unlim-int-soumya/ESE-519-FINAL-PROJECT-Penn-Dinosaurs/code/README.md

# Customer-experience enhancement system!
### By - Team Penn Dinosaurs ☘️

## University of Pennsylvania, ESE 5190: Intro to Embedded Systems - Final Project
    SATYAJEET DAS
        LinkedIn: https://www.linkedin.com/in/satyajeet-das/
    Soumya Dash
        LinkedIn: https://www.linkedin.com/in/srd00/
    Qiao Xu
        LinkedIn: https://www.linkedin.com/in/qiao-xu-b520a3249/

    Tested on:DELL Inspiron 16 Plus (16-inch, 2022), Windows 11 Home 21H2

# Code Overview:<br />

### Detailed Explaination of each line of the code is provided in the "comments" of each code. This section explains the code's overall use and logistics.<br />
## 1. Dino_Game_Code_RP2040:<br />
1. dino.c - main dino game code, where all the helper programs combine to produce the overall game.<br />
2. pwmsnd.c  - driver code for running PWM sound during the game.<br />
3. pwmsnd.h - header file for PWM Sound.<br />
3. vga_graphics.c - driver code for running VGA display.<br />
4. vga_graphics.h -  header file for "vga_graphics".<br />
5. rgb.pio, vsync.pio, hsync.pio - PIO code for VGA Display.<br />
6. Bitmaps.h - Bitmap file for generating the DINO and Cactus.<br />
7. jump.h - Jump Sound<br />
8. gameover.h - Gameover Sound<br />
9. CMakeLists.txt - Cmake File <br />
## 2. Face_Tracking_Pan_Tilt:<br />
1. face_new_main.py - main Face Traking Pan-tilt Code.<br />
2. haarcascade_frontalface_default.xml - Machine Learning Model to detect faces<br />
## 3. Human Interaction Interface:<br />
1. code.py - Main Human Interaction Interface Code.<br />
2. blinding_night.mp3, shape.mp3, song_chris.mp3 - Songs to Play<br />
# Thank You !!!
