unlim-int-soumya/ESE-519-FINAL-PROJECT-Penn-Dinosaurs/diagram/Dino Game.png

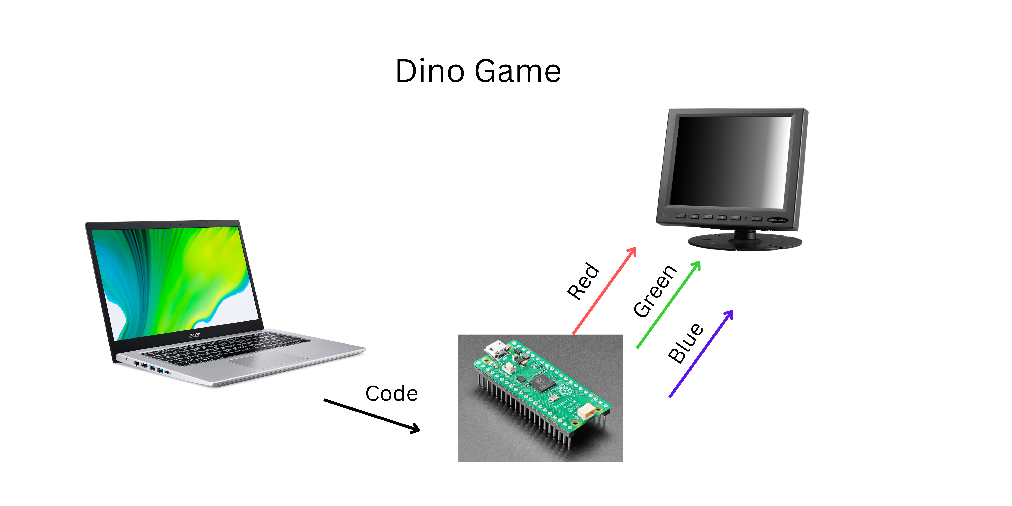
diagram/Dino Game.png
