unlim-int-soumya/ESE-519-FINAL-PROJECT-Penn-Dinosaurs/diagram/ST7735 related pin.jpg

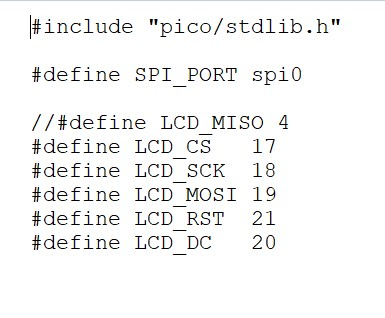
diagram/ST7735 related pin.jpg
