unlim-int-soumya/ESE-519-FINAL-PROJECT-Penn-Dinosaurs/diagram/ST7735 schematic.jpg

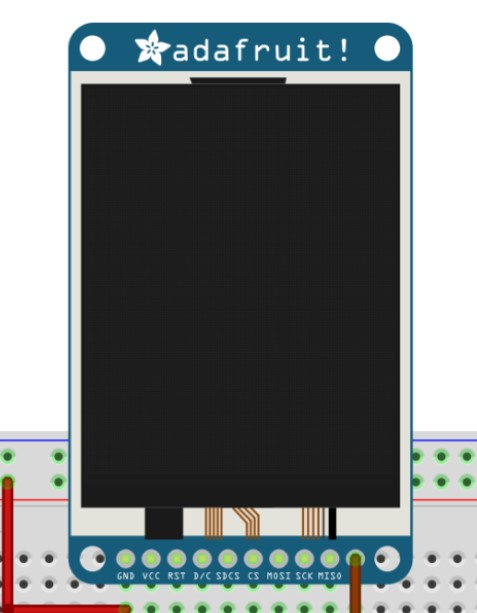
diagram/ST7735 schematic.jpg
