unlim-int-soumya/ESE-519-FINAL-PROJECT-Penn-Dinosaurs/media/Summary of Project.png

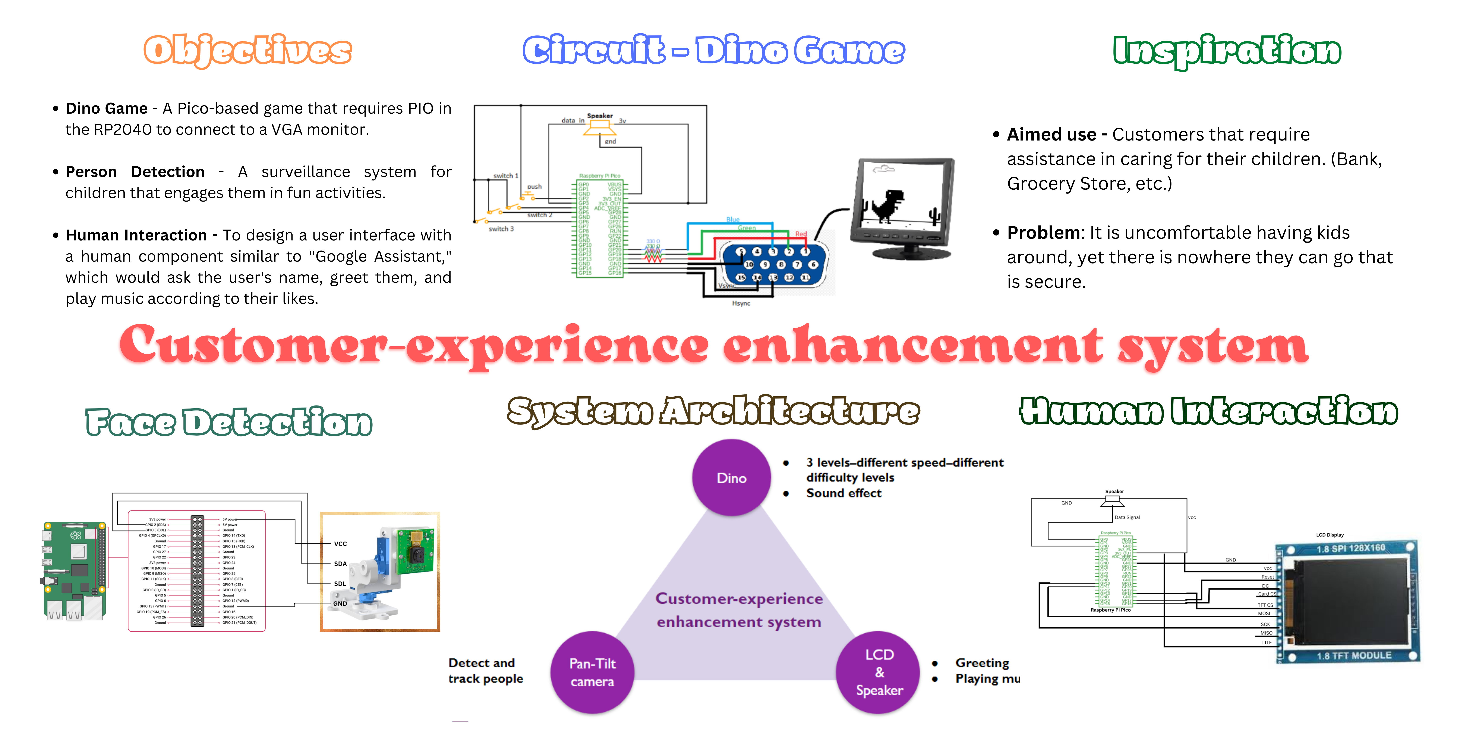
media/Summary of Project.png
