unlim-int-soumya/ESE-519-FINAL-PROJECT-Penn-Dinosaurs/media/materials/1920px-VGA_Port.svg.png

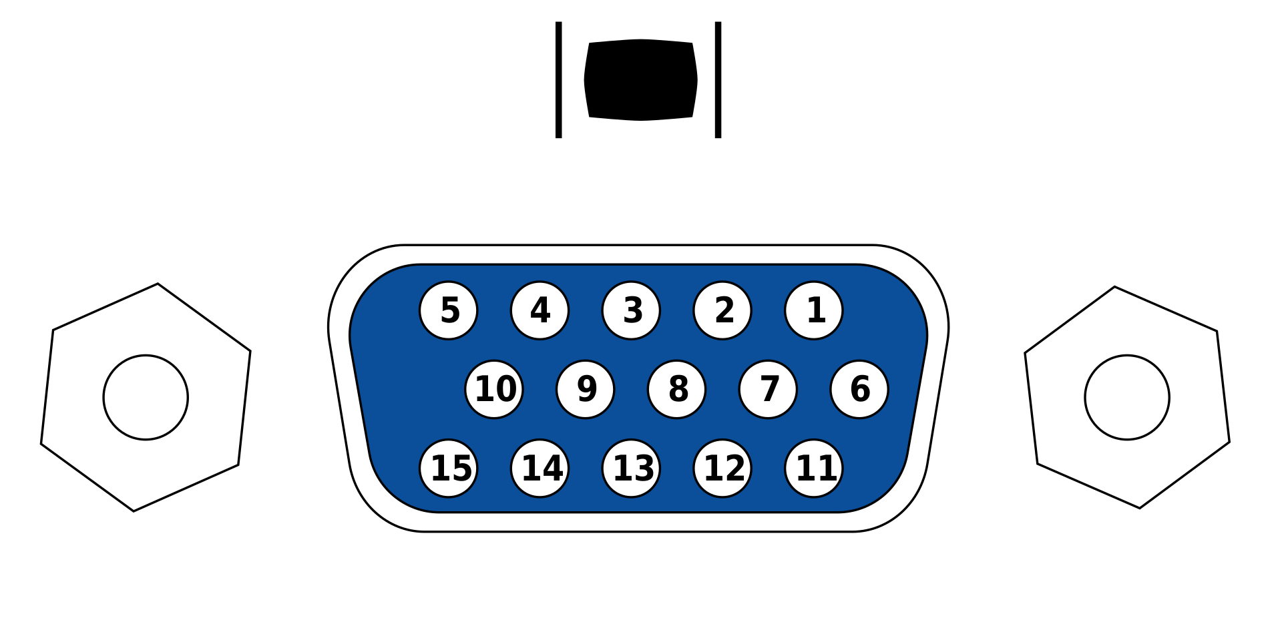
media/materials/1920px-VGA_Port.svg.png
