unlim-int-soumya/ESE-519-FINAL-PROJECT-Penn-Dinosaurs/media/materials/photos of components/pan-tilt.jpg

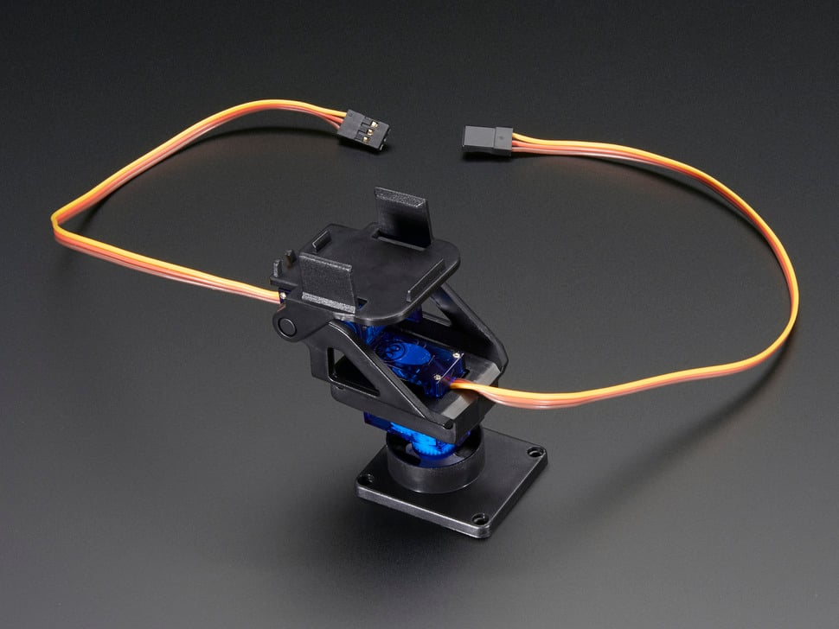
media/materials/photos of components/pan-tilt.jpg
