unlim-int-soumya/ESE-519-FINAL-PROJECT-Penn-Dinosaurs/media/materials/photos of components/Raspberry pi 4 & arducam camera.jpg

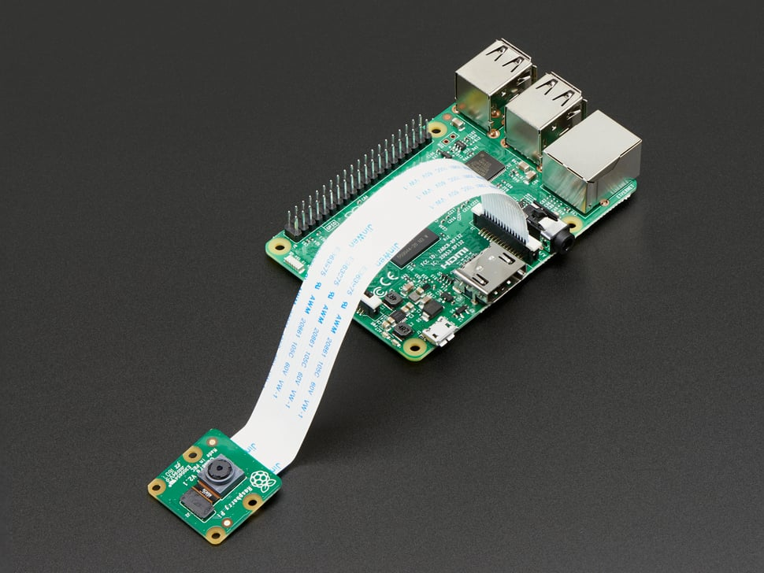
media/materials/photos of components/Raspberry pi 4 & arducam camera.jpg
