unlim-int-soumya/ESE-519-FINAL-PROJECT-Penn-Dinosaurs/media/materials/photos of components/Raspberry pi pico.jpg

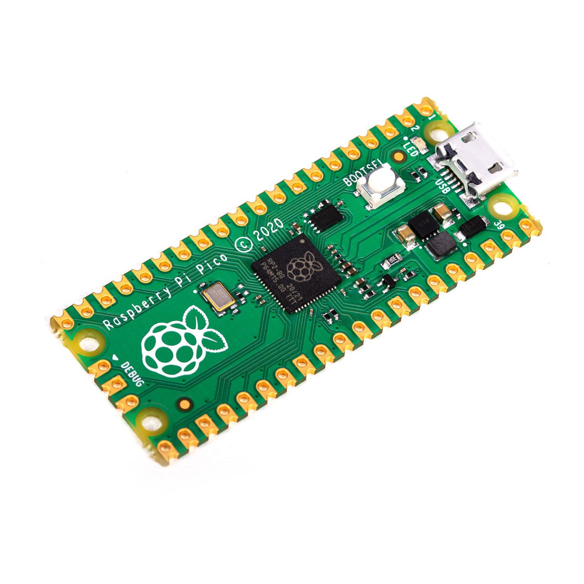
media/materials/photos of components/Raspberry pi pico.jpg
