unlim-int-soumya/ESE-519-FINAL-PROJECT-Penn-Dinosaurs/media/materials/photos of components/Speaker.jpg

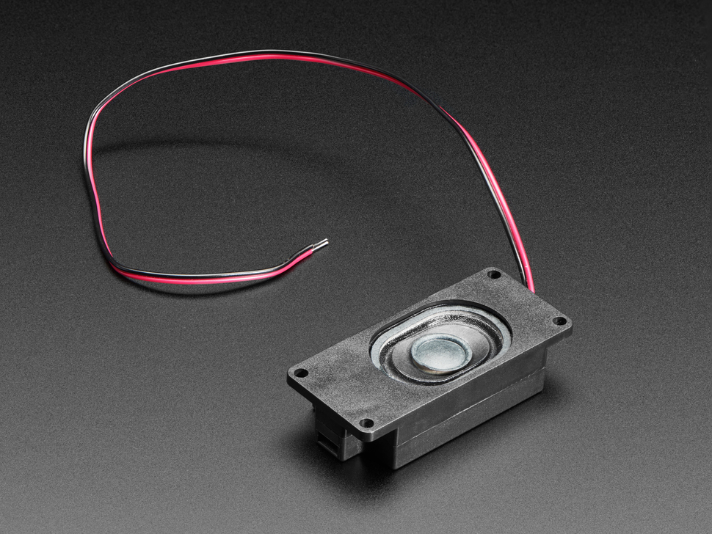
media/materials/photos of components/Speaker.jpg
