unlim-int-soumya/ESE-519-FINAL-PROJECT-Penn-Dinosaurs/media/materials/photos of components/ST7735 TFT Display.jpg

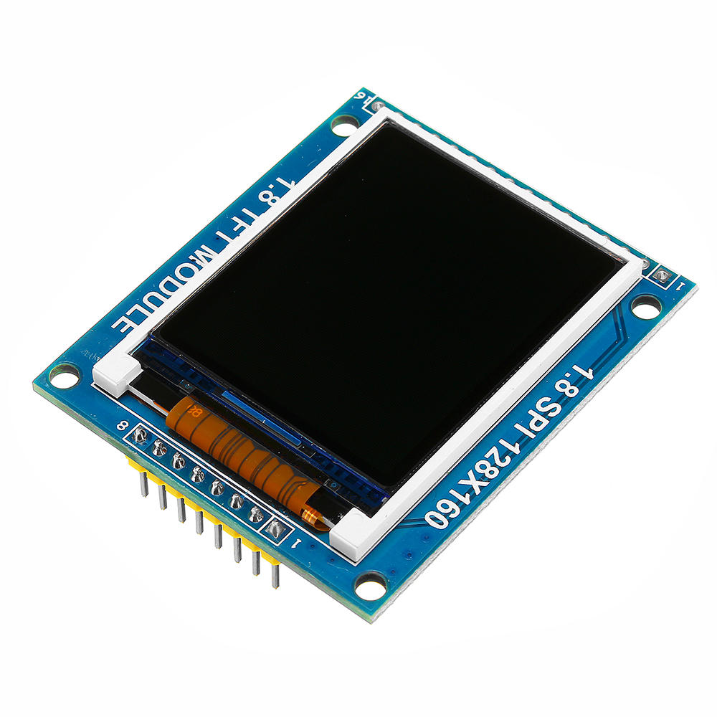
media/materials/photos of components/ST7735 TFT Display.jpg
