unlim-int-soumya/ESE-519-FINAL-PROJECT-Penn-Dinosaurs/media/materials/photos of components/VGA display.jpg

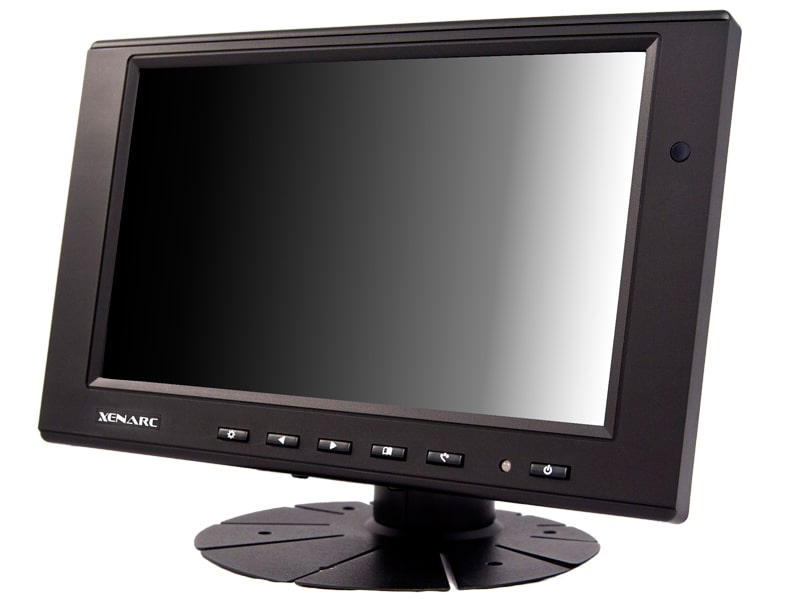
media/materials/photos of components/VGA display.jpg
