unlim-int-soumya/ESE-519-FINAL-PROJECT-Penn-Dinosaurs/media/materials/Populated Breadboard/dino_game_circuit.jpg

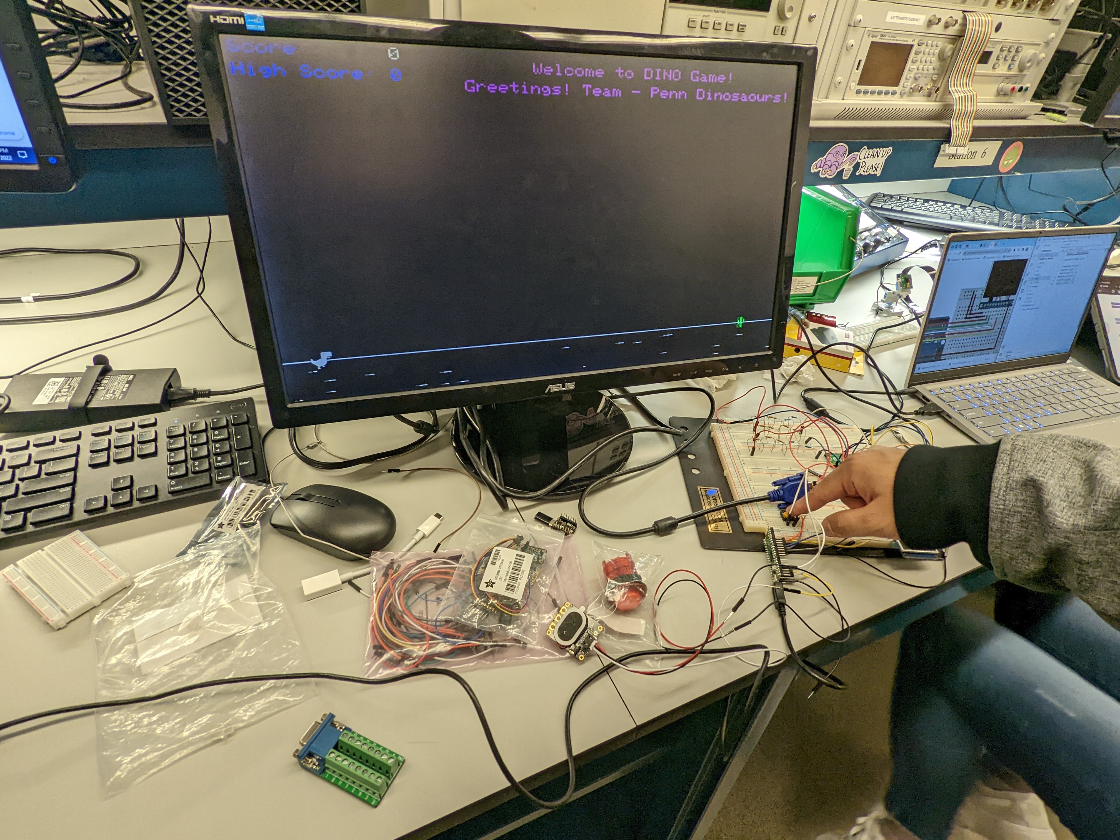
media/materials/Populated Breadboard/dino_game_circuit.jpg
