unlim-int-soumya/ESE-519-FINAL-PROJECT-Penn-Dinosaurs/media/materials/Populated Breadboard/populated_breadboard.png

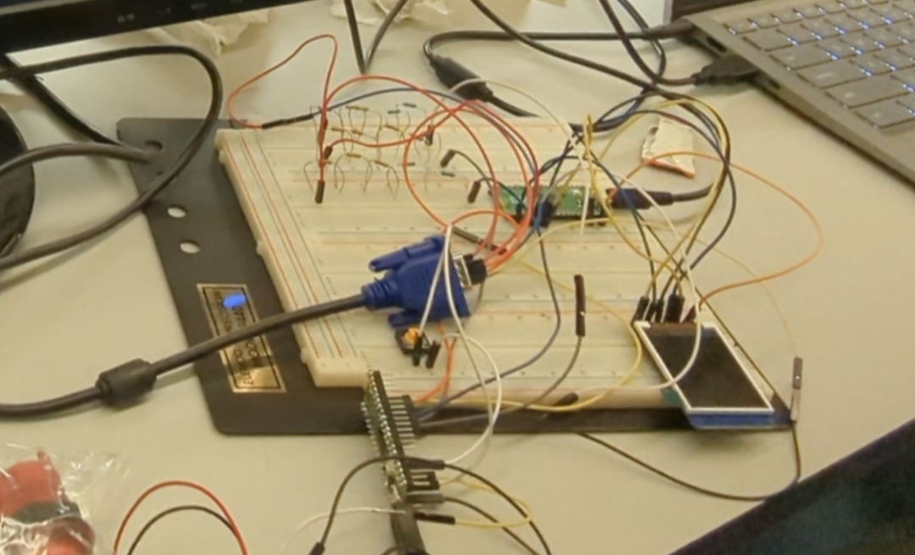
media/materials/Populated Breadboard/populated_breadboard.png
