unlim-int-soumya/ESE-519-FINAL-PROJECT-Penn-Dinosaurs/media/design/3D Printing Button Files/button_holder.STL

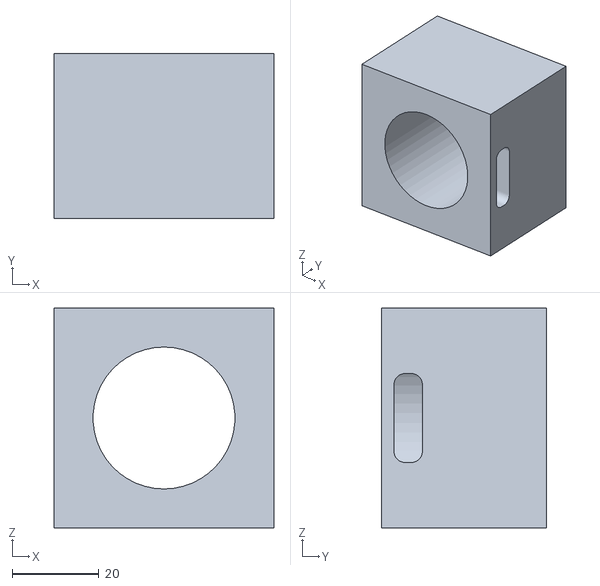
[picture p42: CAD file, 2022-12-28]
media/design/3D Printing Button Files/button_holder.STL
50.8 x 38.1 x 50.8
