unlim-int-soumya/ESE-519-FINAL-PROJECT-Penn-Dinosaurs/code/Dino_Game_Code_RP2040/gameover.h

// gameover sound
const uint8_t gameover[43971] = {
	0x7F, 0x7E, 0x80, 0x81, 0x80, 0x7F, 0x80, 0x7F, 0x80, 0x80, 0x80, 0x80, 0x80, 0x7F, 0x7F, 0x7F, 
	0x7F, 0x7F, 0x7F, 0x80, 0x7F, 0x7F, 0x7F, 0x80, 0x82, 0x81, 0x81, 0x81, 0x82, 0x84, 0x83, 0x81, 
	0x81, 0x81, 0x82, 0x82, 0x81, 0x81, 0x82, 0x84, 0x84, 0x84, 0x82, 0x84, 0x84, 0x84, 0x83, 0x82, 
	0x83, 0x83, 0x82, 0x81, 0x80, 0x82, 0x82, 0x80, 0x80, 0x80, 0x80, 0x80, 0x80, 0x7E, 0x80, 0x80, 
	0x7F, 0x7E, 0x7E, 0x7E, 0x7F, 0x7E, 0x7D, 0x7C, 0x7E, 0x7E, 0x7E, 0x7C, 0x7C, 0x7D, 0x7E, 0x7D, 
	0x7B, 0x7D, 0x7D, 0x7E, 0x7E, 0x7E, 0x7E, 0x7D, 0x7E, 0x7E, 0x7F, 0x7E, 0x7C, 0x7D, 0x7D, 0x7F, 
	0x7E, 0x7D, 0x7F, 0x80, 0x80, 0x80, 0x80, 0x81, 0x83, 0x82, 0x82, 0x82, 0x82, 0x82, 0x84, 0x85, 
	0x85, 0x86, 0x86, 0x85, 0x86, 0x86, 0x87, 0x86, 0x86, 0x84, 0x84, 0x84, 0x83, 0x82, 0x82, 0x82, 
	0x81, 0x81, 0x80, 0x82, 0x81, 0x82, 0x82, 0x82, 0x82, 0x81, 0x81, 0x80, 0x7F, 0x7E, 0x7E, 0x7F, 
	0x7F, 0x7E, 0x7F, 0x83, 0x84, 0x82, 0x7F, 0x7F, 0x80, 0x7E, 0x7A, 0x78, 0x79, 0x79, 0x78, 0x78, 
	0x79, 0x7B, 0x7B, 0x7A, 0x7D, 0x7D, 0x7C, 0x7B, 0x7A, 0x7C, 0x7C, 0x7D, 0x7C, 0x7C, 0x7C, 0x7E, 
	0x7E, 0x7E, 0x7E, 0x7F, 0x7F, 0x81, 0x80, 0x80, 0x81, 0x80, 0x80, 0x81, 0x80, 0x81, 0x80, 0x81, 
	0x80, 0x81, 0x82, 0x83, 0x82, 0x82, 0x81, 0x81, 0x83, 0x84, 0x84, 0x85, 0x85, 0x86, 0x87, 0x88, 
	0x89, 0x88, 0x89, 0x8B, 0x88, 0x86, 0x85, 0x86, 0x85, 0x84, 0x82, 0x83, 0x83, 0x82, 0x82, 0x82, 
	0x83, 0x80, 0x80, 0x81, 0x80, 0x7E, 0x7A, 0x7A, 0x7B, 0x7B, 0x79, 0x79, 0x7B, 0x7C, 0x7D, 0x7F, 
	0x7F, 0x7E, 0x7D, 0x7D, 0x7D, 0x7E, 0x7C, 0x7A, 0x7A, 0x7B, 0x7A, 0x79, 0x79, 0x79, 0x7C, 0x7D, 
	0x7C, 0x7C, 0x7B, 0x7B, 0x7B, 0x7B, 0x79, 0x78, 0x7B, 0x7C, 0x7E, 0x7D, 0x81, 0x83, 0x85, 0x86, 
	0x87, 0x87, 0x85, 0x86, 0x88, 0x88, 0x85, 0x84, 0x86, 0x88, 0x87, 0x86, 0x87, 0x88, 0x86, 0x84, 
	0x82, 0x83, 0x82, 0x81, 0x83, 0x85, 0x83, 0x84, 0x85, 0x88, 0x89, 0x88, 0x86, 0x87, 0x87, 0x86, 
	0x83, 0x82, 0x82, 0x83, 0x85, 0x84, 0x81, 0x81, 0x84, 0x85, 0x82, 0x7D, 0x7B, 0x7A, 0x79, 0x74, 
	0x72, 0x73, 0x74, 0x72, 0x71, 0x73, 0x76, 0x76, 0x76, 0x75, 0x78, 0x7A, 0x7A, 0x7B, 0x7A, 0x7A, 
	0x7C, 0x7D, 0x7E, 0x7E, 0x7E, 0x7E, 0x7F, 0x80, 0x80, 0x81, 0x81, 0x7F, 0x7D, 0x7D, 0x7E, 0x7C, 
	0x7A, 0x78, 0x78, 0x7A, 0x7A, 0x7A, 0x7A, 0x7E, 0x80, 0x80, 0x7F, 0x7E, 0x80, 0x85, 0x88, 0x87, 
	0x86, 0x8A, 0x8E, 0x91, 0x92, 0x92, 0x94, 0x97, 0x97, 0x93, 0x8F, 0x8D, 0x8D, 0x8B, 0x89, 0x85, 
	0x83, 0x81, 0x82, 0x82, 0x81, 0x7E, 0x7F, 0x7F, 0x7E, 0x7B, 0x7A, 0x79, 0x7A, 0x7A, 0x7A, 0x7B, 
	0x7B, 0x7C, 0x7D, 0x7E, 0x80, 0x81, 0x80, 0x7E, 0x7C, 0x7B, 0x79, 0x79, 0x76, 0x74, 0x74, 0x77, 
	0x78, 0x77, 0x76, 0x78, 0x7D, 0x7D, 0x77, 0x75, 0x79, 0x7B, 0x79, 0x74, 0x76, 0x7A, 0x7D, 0x7D, 
	0x7E, 0x81, 0x84, 0x84, 0x84, 0x84, 0x82, 0x83, 0x83, 0x80, 0x7C, 0x7D, 0x82, 0x86, 0x83, 0x7F, 
	0x81, 0x87, 0x89, 0x86, 0x83, 0x85, 0x88, 0x89, 0x8A, 0x8D, 0x8F, 0x8F, 0x90, 0x91, 0x92, 0x91, 
	0x8E, 0x8D, 0x8F, 0x8E, 0x8B, 0x89, 0x89, 0x8A, 0x87, 0x84, 0x81, 0x80, 0x7F, 0x7E, 0x7B, 0x78, 
	0x77, 0x77, 0x76, 0x74, 0x72, 0x71, 0x72, 0x72, 0x72, 0x72, 0x74, 0x75, 0x77, 0x79, 0x7C, 0x7C, 
	0x7D, 0x80, 0x81, 0x82, 0x80, 0x7F, 0x7E, 0x7F, 0x7F, 0x7C, 0x7B, 0x79, 0x7A, 0x7A, 0x78, 0x76, 
	0x74, 0x72, 0x6E, 0x6A, 0x6A, 0x6B, 0x6A, 0x67, 0x67, 0x6A, 0x6F, 0x74, 0x79, 0x7D, 0x7F, 0x83, 
	0x88, 0x8D, 0x8F, 0x91, 0x94, 0x98, 0x9B, 0x9C, 0x9B, 0x9C, 0x9F, 0x9E, 0x9D, 0x9A, 0x96, 0x92, 
	0x8E, 0x8C, 0x8A, 0x86, 0x7F, 0x7E, 0x80, 0x80, 0x7F, 0x7E, 0x7F, 0x80, 0x80, 0x80, 0x81, 0x81, 
	0x80, 0x7F, 0x80, 0x83, 0x84, 0x82, 0x81, 0x83, 0x87, 0x87, 0x84, 0x81, 0x7F, 0x7F, 0x7D, 0x7B, 
	0x77, 0x74, 0x73, 0x75, 0x75, 0x75, 0x73, 0x75, 0x78, 0x78, 0x77, 0x75, 0x75, 0x75, 0x75, 0x74, 
	0x74, 0x73, 0x74, 0x74, 0x74, 0x77, 0x7A, 0x7B, 0x79, 0x77, 0x79, 0x7E, 0x7F, 0x7A, 0x75, 0x75, 
	0x7C, 0x7F, 0x7C, 0x79, 0x7C, 0x84, 0x87, 0x88, 0x89, 0x8D, 0x92, 0x93, 0x94, 0x93, 0x93, 0x93, 
	0x93, 0x93, 0x92, 0x8F, 0x8F, 0x8E, 0x8E, 0x8D, 0x8D, 0x8D, 0x8B, 0x89, 0x85, 0x82, 0x81, 0x7E, 
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
};
