unlim-int-soumya/ESE-519-FINAL-PROJECT-Penn-Dinosaurs/code/Dino_Game_Code_RP2040/jump.h

// dino jump sound
const uint8_t jumpsnd[14648] = {
	0x80, 0x80, 0x80, 0x80, 0x80, 0x80, 0x80, 0x80, 0x80, 0x7F, 0x7F, 0x80, 0x7F, 0x7F, 0x7F, 0x7F, 
	0x7E, 0x7F, 0x80, 0x80, 0x7F, 0x82, 0x82, 0x81, 0x80, 0x82, 0x82, 0x7F, 0x7F, 0x80, 0x7C, 0x7B, 
	0x7C, 0x7D, 0x7A, 0x79, 0x79, 0x7A, 0x7A, 0x7A, 0x7B, 0x7B, 0x7A, 0x7C, 0x7E, 0x7F, 0x7E, 0x7E, 
	0x7E, 0x7C, 0x7A, 0x7B, 0x7E, 0x7E, 0x7E, 0x82, 0x86, 0x87, 0x88, 0x84, 0x7B, 0x7A, 0x84, 0x89, 
	0x83, 0x7C, 0x7C, 0x7C, 0x7B, 0x7C, 0x87, 0x8B, 0x85, 0x7F, 0x81, 0x84, 0x83, 0x82, 0x82, 0x81, 
	0x7E, 0x7C, 0x7C, 0x7C, 0x7E, 0x85, 0x8B, 0x87, 0x81, 0x81, 0x82, 0x7D, 0x7C, 0x86, 0x97, 0x92, 
	0x7E, 0x7C, 0x8E, 0x8B, 0x6E, 0x64, 0x86, 0xA2, 0x87, 0x5D, 0x60, 0x81, 0x92, 0x8D, 0x82, 0x6F, 
	0x69, 0x85, 0xA1, 0x90, 0x71, 0x80, 0x9C, 0x8D, 0x70, 0x74, 0x78, 0x67, 0x61, 0x78, 0x86, 0x80, 
	0x76, 0x66, 0x55, 0x64, 0x8B, 0xA7, 0xAD, 0xA2, 0x7C, 0x50, 0x51, 0x76, 0x90, 0x93, 0x96, 0x9B, 
	0x99, 0x91, 0x81, 0x76, 0x78, 0x74, 0x5C, 0x48, 0x4F, 0x6A, 0x88, 0x9D, 0x9E, 0x87, 0x6E, 0x77, 
	0x94, 0xA1, 0x86, 0x63, 0x6E, 0xB0, 0xE2, 0xCC, 0x8D, 0x55, 0x30, 0x22, 0x2E, 0x54, 0x8F, 0xC7, 
	0xE5, 0xE5, 0xCB, 0x94, 0x52, 0x27, 0x29, 0x54, 0x97, 0xD2, 0xDB, 0xB2, 0x7C, 0x55, 0x3E, 0x30, 
	0x3A, 0x66, 0xA1, 0xC0, 0xAE, 0x78, 0x47, 0x45, 0x78, 0xB2, 0xC3, 0x98, 0x51, 0x25, 0x33, 0x67, 
	0x9D, 0xC7, 0xD9, 0xB6, 0x68, 0x28, 0x20, 0x4D, 0x93, 0xC5, 0xCE, 0xB7, 0x8F, 0x5D, 0x2F, 0x1C, 
	0x3C, 0x83, 0xC0, 0xCA, 0x98, 0x53, 0x3A, 0x5F, 0x98, 0xB2, 0xA2, 0x85, 0x6E, 0x5A, 0x4E, 0x61, 
	0x97, 0xCD, 0xDC, 0xBE, 0x85, 0x52, 0x41, 0x5A, 0x8B, 0xBB, 0xD4, 0xC9, 0xA3, 0x75, 0x5B, 0x63, 
	0x83, 0xA2, 0xAA, 0x99, 0x85, 0x8A, 0xA1, 0xAB, 0xA0, 0x8F, 0x7E, 0x6E, 0x5F, 0x5E, 0x71, 0x95, 
	0xB4, 0xBC, 0xAD, 0x8F, 0x6F, 0x5C, 0x5D, 0x67, 0x77, 0x89, 0x9C, 0xA3, 0x94, 0x7B, 0x6C, 0x6A, 
	0x6A, 0x65, 0x67, 0x71, 0x7D, 0x87, 0x87, 0x7C, 0x6E, 0x6A, 0x6A, 0x69, 0x68, 0x69, 0x71, 0x78, 
	0x7A, 0x7C, 0x7E, 0x7E, 0x7C, 0x75, 0x6B, 0x65, 0x66, 0x6C, 0x74, 0x7C, 0x88, 0x8C, 0x83, 0x72, 
	0x61, 0x5C, 0x61, 0x6F, 0x79, 0x82, 0x88, 0x8B, 0x89, 0x87, 0x88, 0x83, 0x74, 0x64, 0x65, 0x74, 
	0x83, 0x87, 0x87, 0x88, 0x82, 0x77, 0x6E, 0x6A, 0x6E, 0x7F, 0x8F, 0x8F, 0x81, 0x76, 0x79, 0x82, 
	0x87, 0x85, 0x7F, 0x7B, 0x79, 0x7A, 0x80, 0x88, 0x91, 0x99, 0x9C, 0x91, 0x7D, 0x6C, 0x6D, 0x7C, 
	0x8A, 0x8B, 0x8B, 0x8B, 0x83, 0x76, 0x6F, 0x71, 0x79, 0x83, 0x89, 0x8A, 0x89, 0x85, 0x82, 0x84, 
	0x8B, 0x93, 0x94, 0x86, 0x75, 0x73, 0x7C, 0x81, 0x85, 0x8E, 0x91, 0x89, 0x88, 0x89, 0x78, 0x5F, 
	0x67, 0x91, 0xA4, 0x82, 0x61, 0x7F, 0xB0, 0xAA, 0x75, 0x60, 0x79, 0x8E, 0x86, 0x8A, 0xA7, 0xB7, 
	0xA3, 0x82, 0x70, 0x70, 0x7D, 0x89, 0x8C, 0x8B, 0x90, 0x9D, 0xA3, 0x91, 0x72, 0x64, 0x76, 0x86, 
	0x7F, 0x76, 0x8A, 0xA9, 0xA7, 0x8B, 0x7A, 0x7D, 0x78, 0x6C, 0x7A, 0xA7, 0xC3, 0xB7, 0x9B, 0x88, 
	0x7A, 0x69, 0x6A, 0x84, 0x9C, 0xA0, 0x98, 0x92, 0x89, 0x80, 0x78, 0x74, 0x73, 0x78, 0x86, 0x91, 
	0x8F, 0x89, 0x8B, 0x8C, 0x80, 0x6E, 0x65, 0x72, 0x8C, 0xA0, 0xA2, 0x9A, 0x8D, 0x7A, 0x62, 0x51, 
	0x53, 0x68, 0x87, 0x9E, 0xA2, 0x95, 0x88, 0x7F, 0x6D, 0x59, 0x58, 0x6C, 0x82, 0x89, 0x83, 0x7A, 
	0x78, 0x7E, 0x8C, 0x98, 0x99, 0x92, 0x84, 0x75, 0x70, 0x76, 0x7C, 0x81, 0x7F, 0x74, 0x62, 0x56, 
	0x56, 0x5B, 0x5F, 0x66, 0x75, 0x7D, 0x7E, 0x7C, 0x77, 0x70, 0x70, 0x76, 0x7B, 0x80, 0x88, 0x85, 
	0x75, 0x6A, 0x6A, 0x67, 0x66, 0x6A, 0x74, 0x7C, 0x82, 0x83, 0x77, 0x64, 0x63, 0x73, 0x7E, 0x78, 
	0x69, 0x5E, 0x5D, 0x69, 0x7D, 0x8C, 0x89, 0x78, 0x67, 0x60, 0x66, 0x75, 0x80, 0x8E, 0x96, 0x88, 
	0x69, 0x56, 0x5D, 0x77, 0x8C, 0x8A, 0x74, 0x64, 0x63, 0x68, 0x6A, 0x6A, 0x6A, 0x6D, 0x73, 0x7E, 
	0x88, 0x88, 0x7D, 0x76, 0x7B, 0x83, 0x8B, 0x91, 0x8C, 0x83, 0x85, 0x92, 0x98, 0x92, 0x91, 0x91, 
	0x84, 0x73, 0x76, 0x7E, 0x7D, 0x7C, 0x84, 0x81, 0x6C, 0x56, 0x51, 0x5B, 0x76, 0x9C, 0xB6, 0xB6, 
	0xA5, 0x91, 0x7D, 0x68, 0x5D, 0x5F, 0x74, 0x98, 0xBE, 0xCC, 0xBE, 0xA9, 0x97, 0x80, 0x68, 0x5D, 
	0x5E, 0x6C, 0x7D, 0x89, 0x8C, 0x8E, 0x8B, 0x80, 0x72, 0x67, 0x64, 0x6C, 0x85, 0xA8, 0xBD, 0xBB, 
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
};
